B0risma/CapMeter/схемы.docx

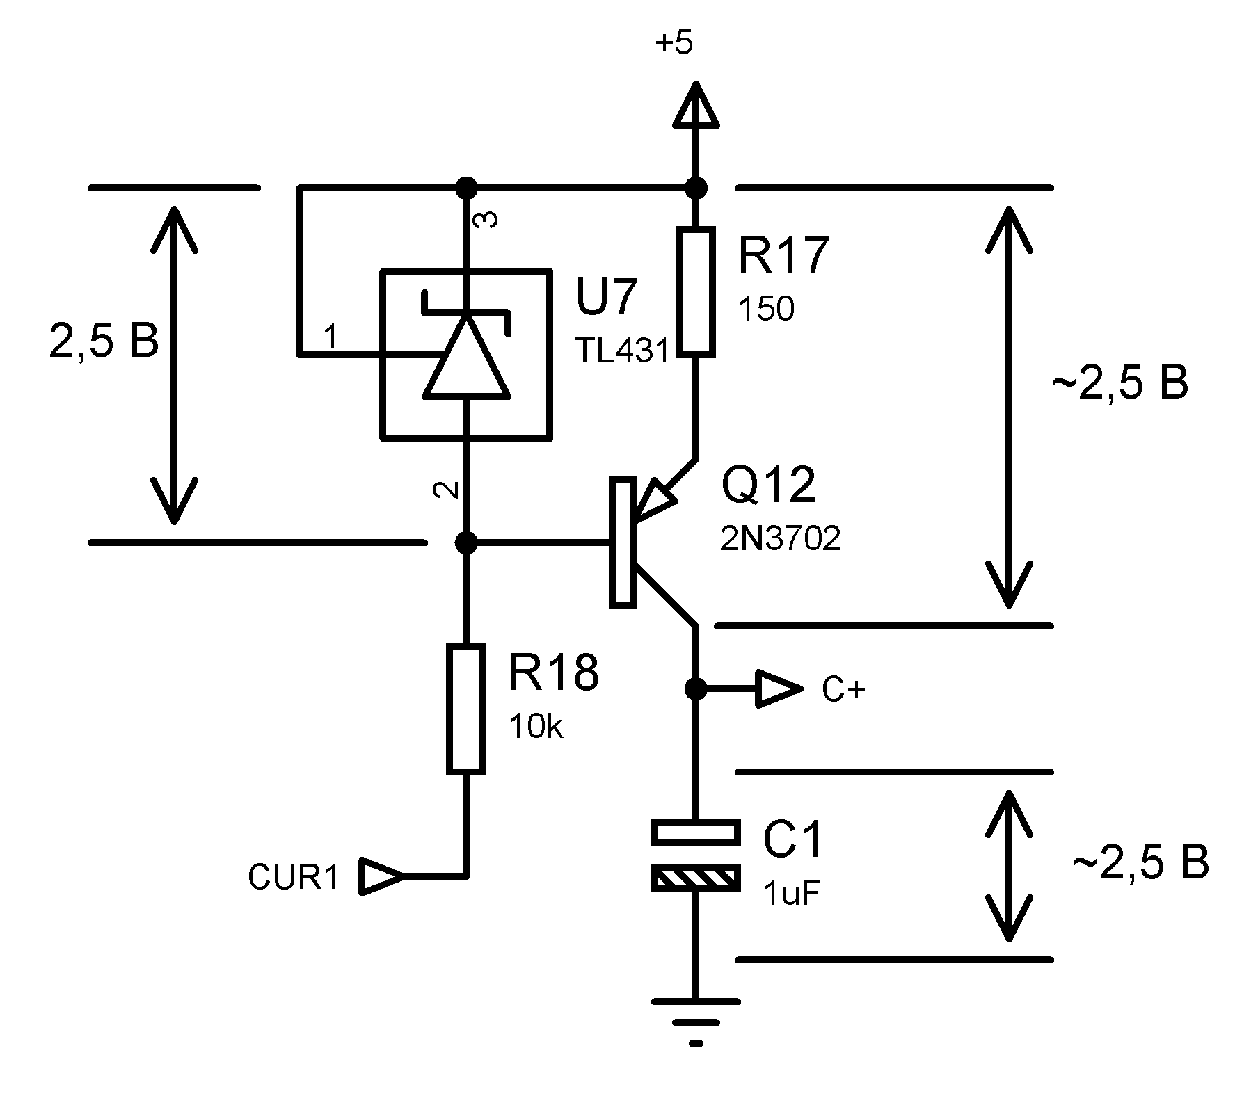
[picture p22: figure]
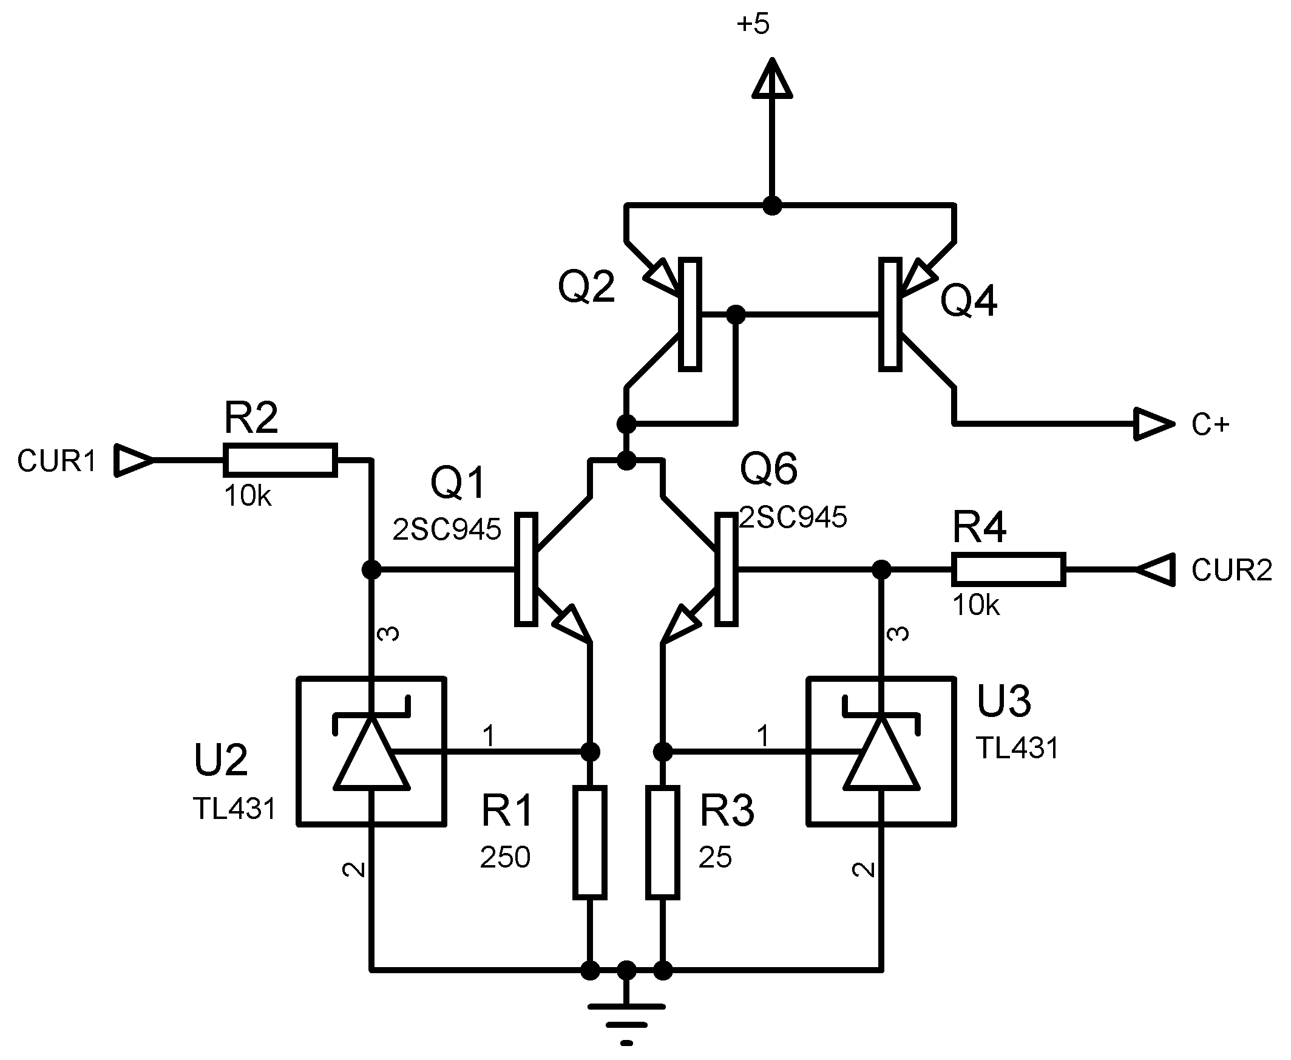
[picture p23: figure]
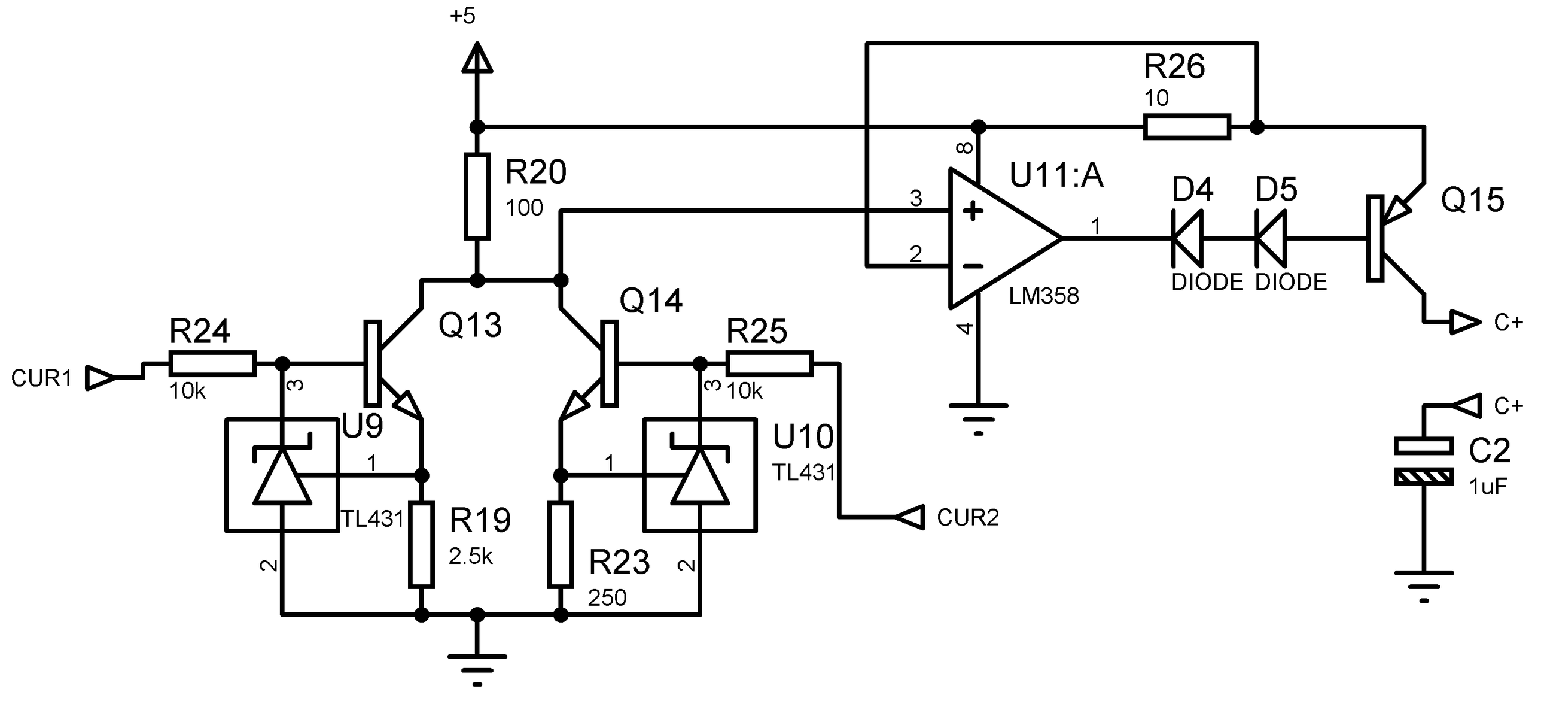
[picture p24: figure]
