B0risma/CapMeter/din41328-4_1974-06d(измерение емкости).pdf

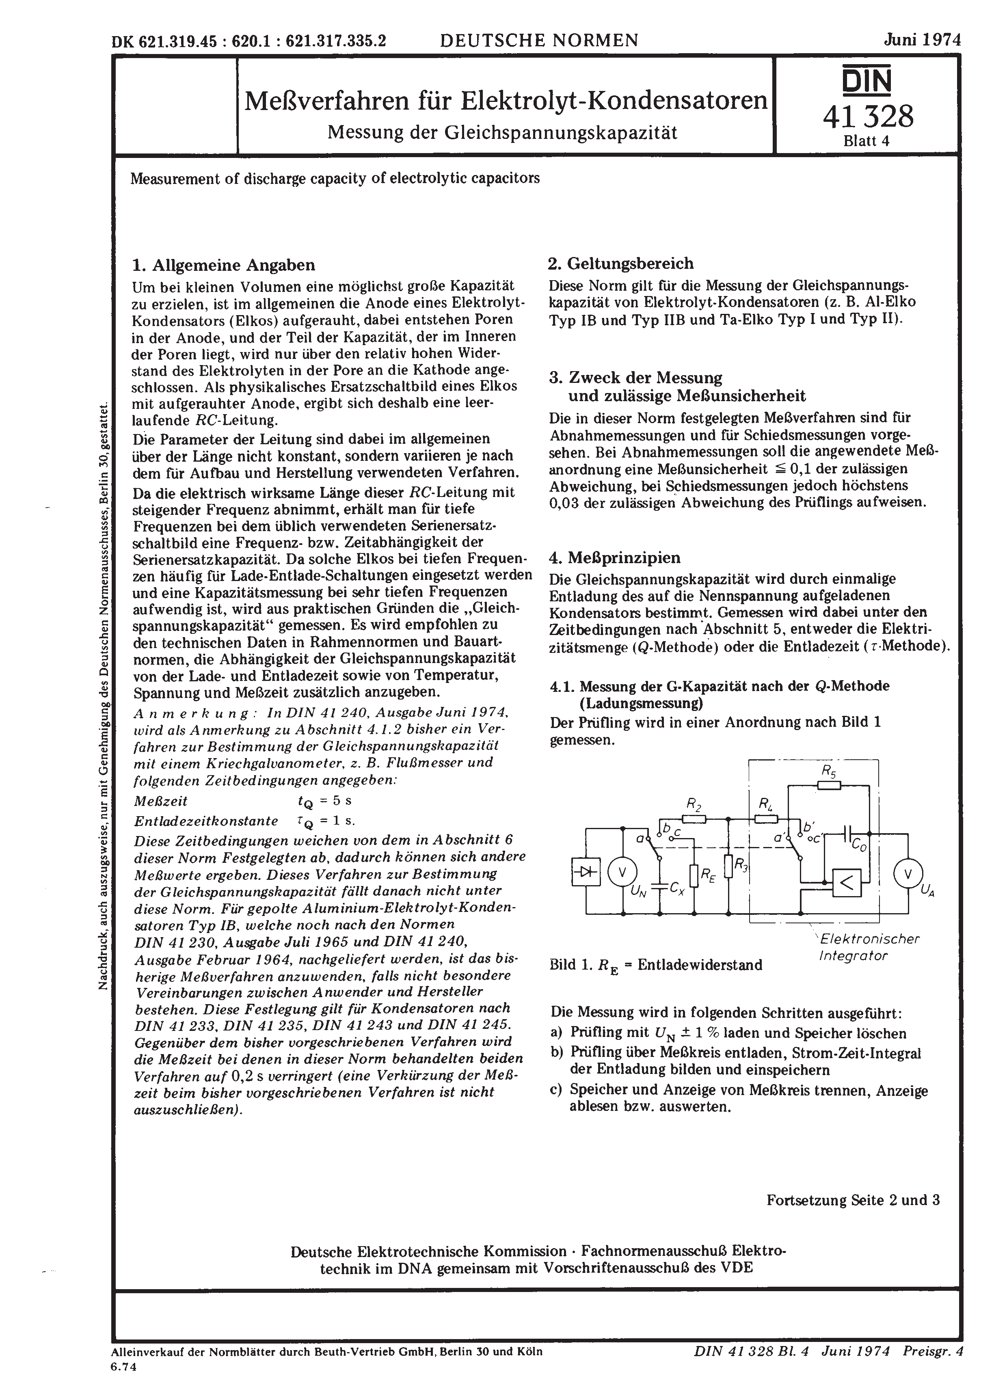
[picture p25: page 1]
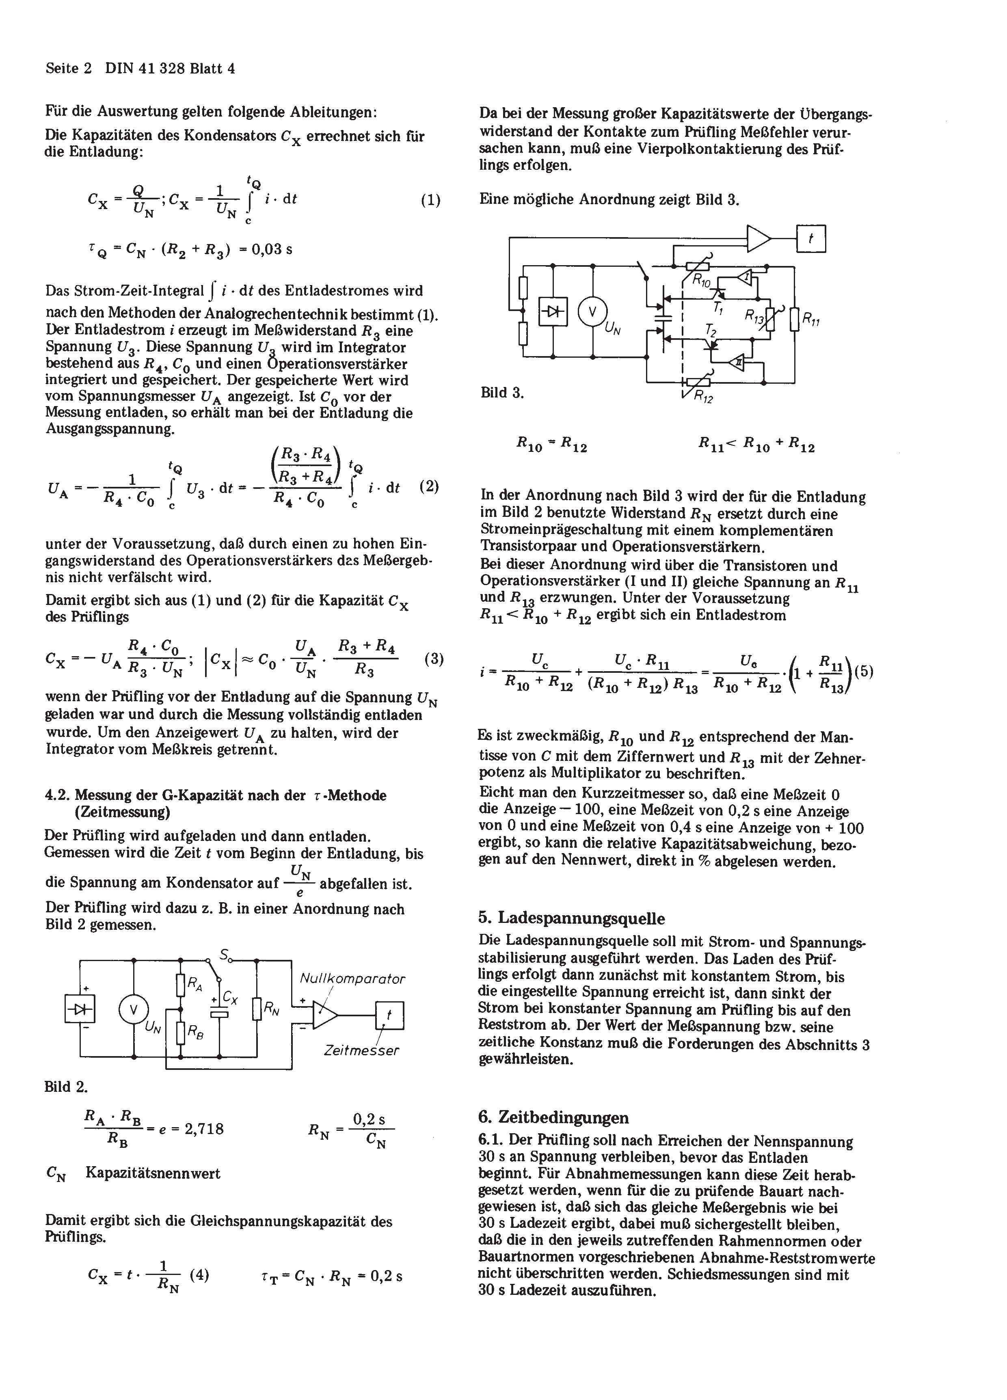
[picture p26: page 2]
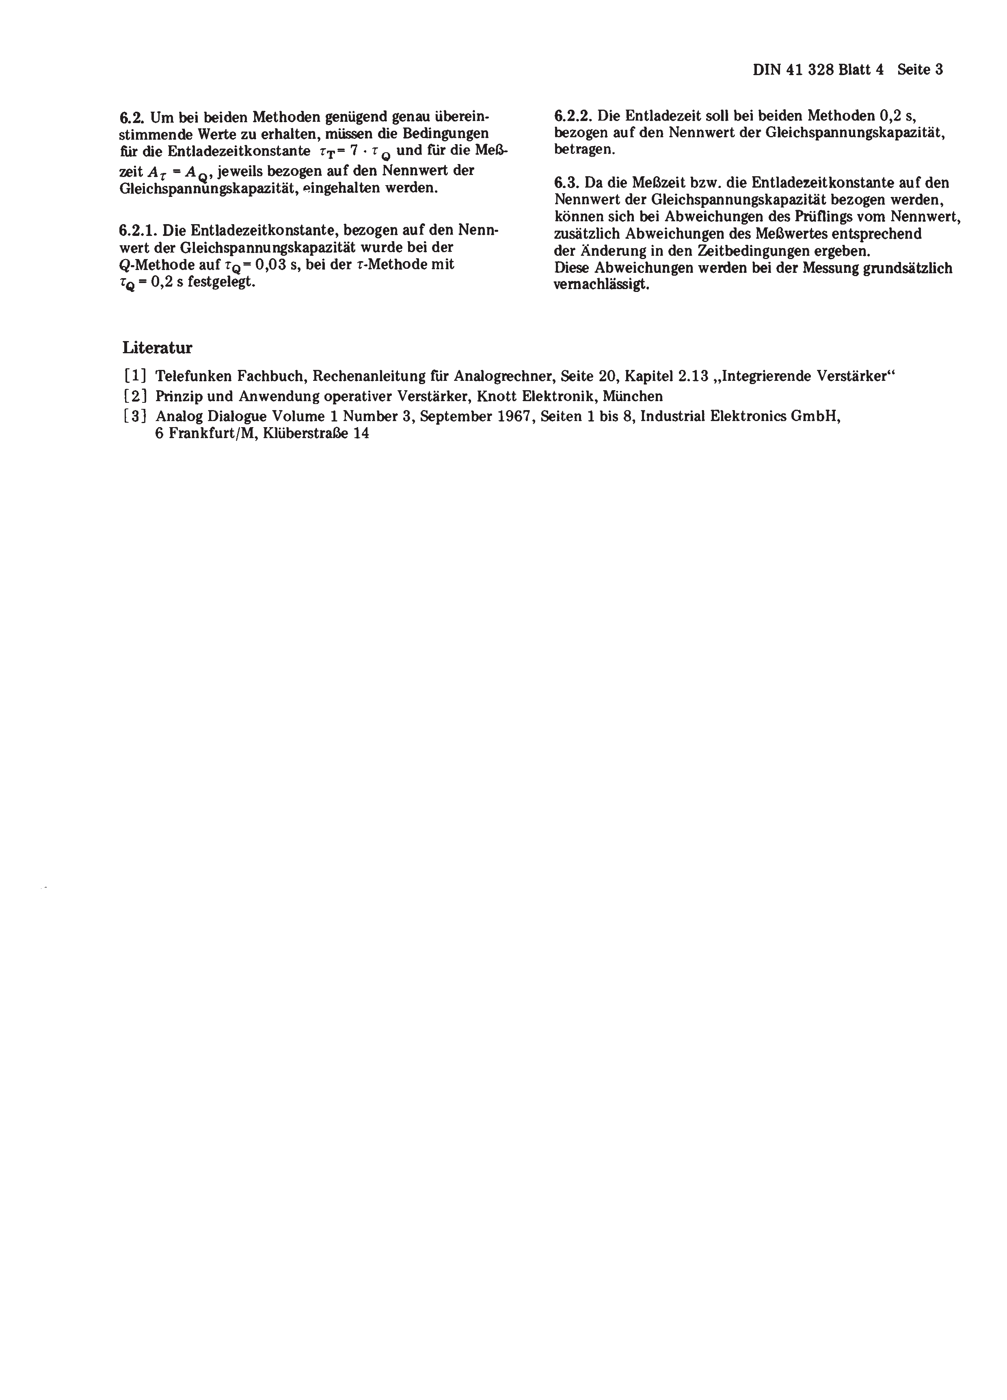
[picture p27: page 3]
