B0risma/CapMeter/cxem.BMP

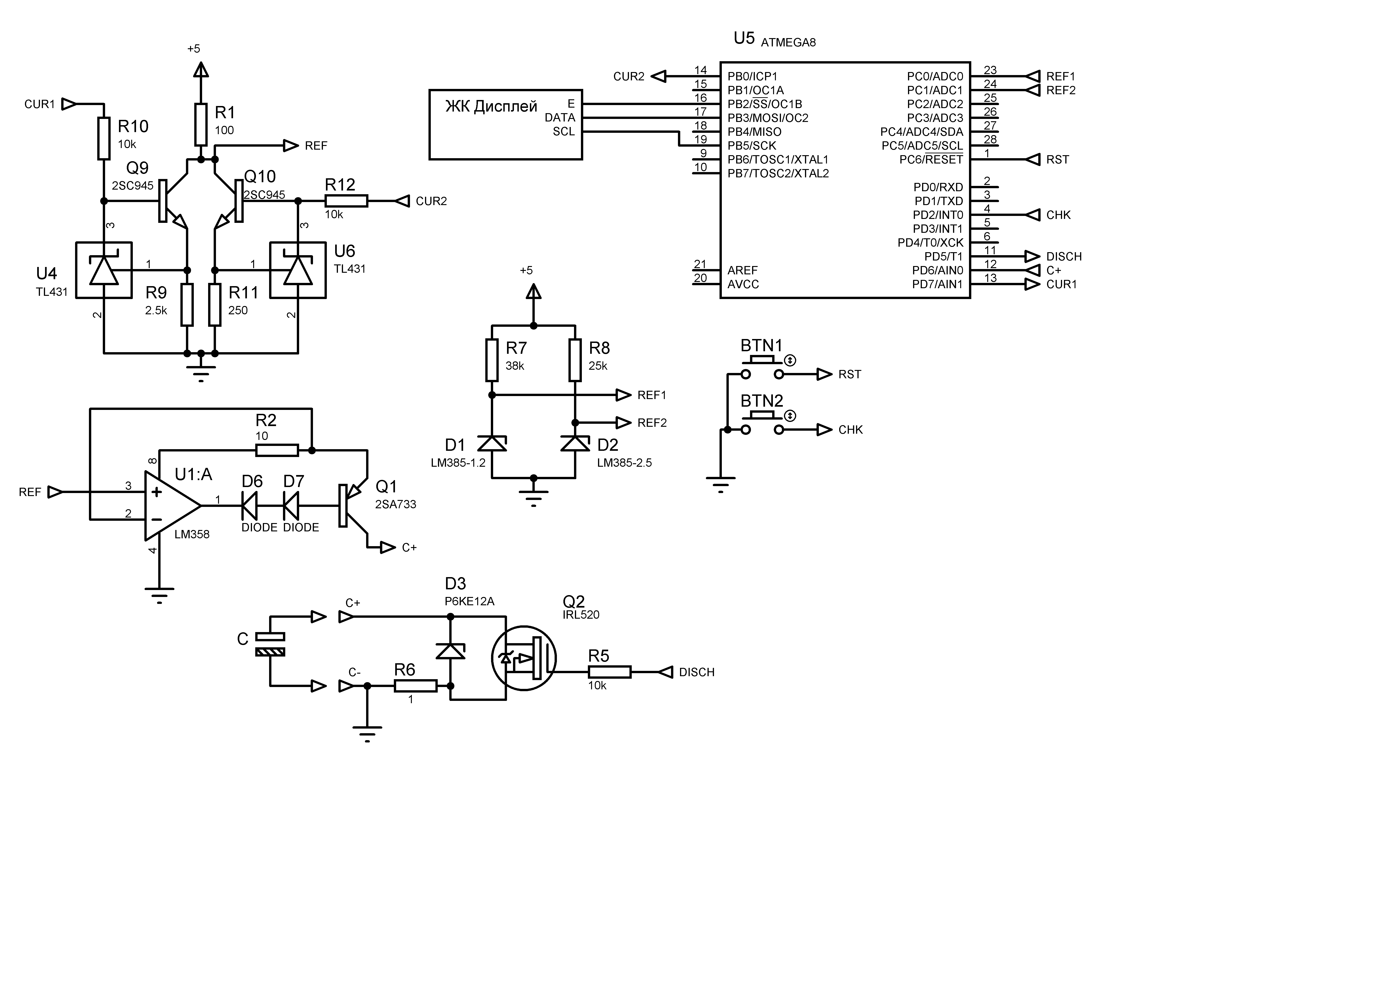
cxem.BMP
