B0risma/CapMeter/ESR4.jpg

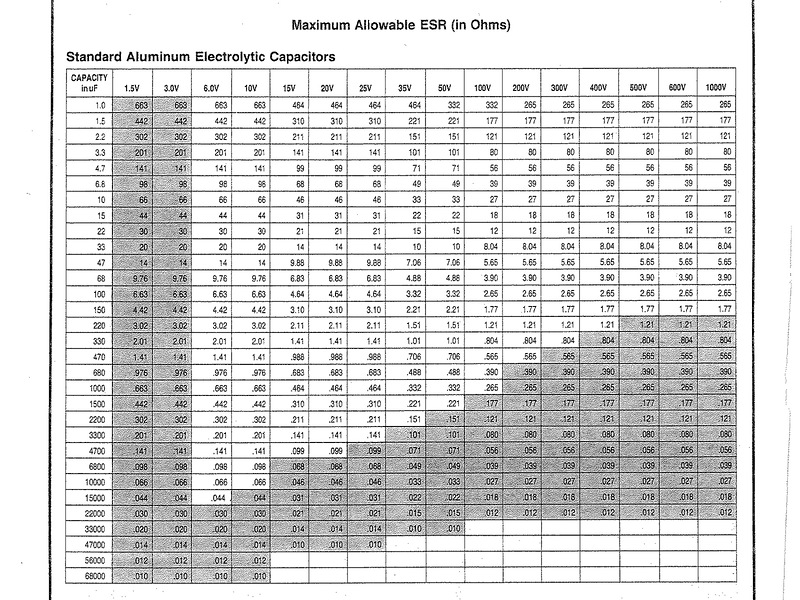
ESR4.jpg
