B0risma/CapMeter/ESR.jpg

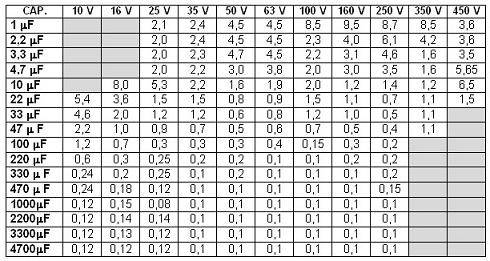
ESR.jpg
