B0risma/CapMeter/LCD_board.bmp

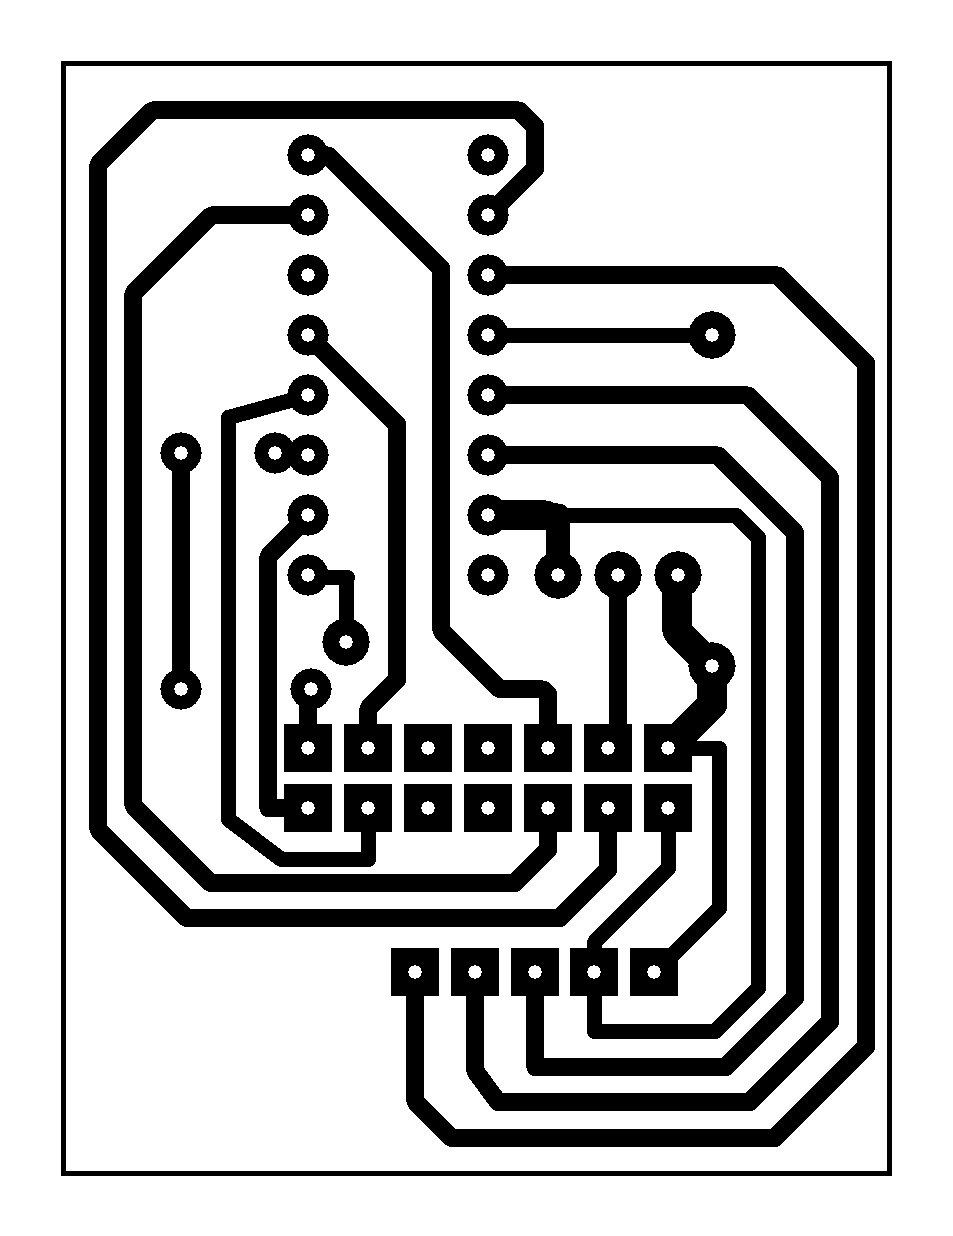
LCD_board.bmp
