B0risma/CapMeter/Screenshot_1.png

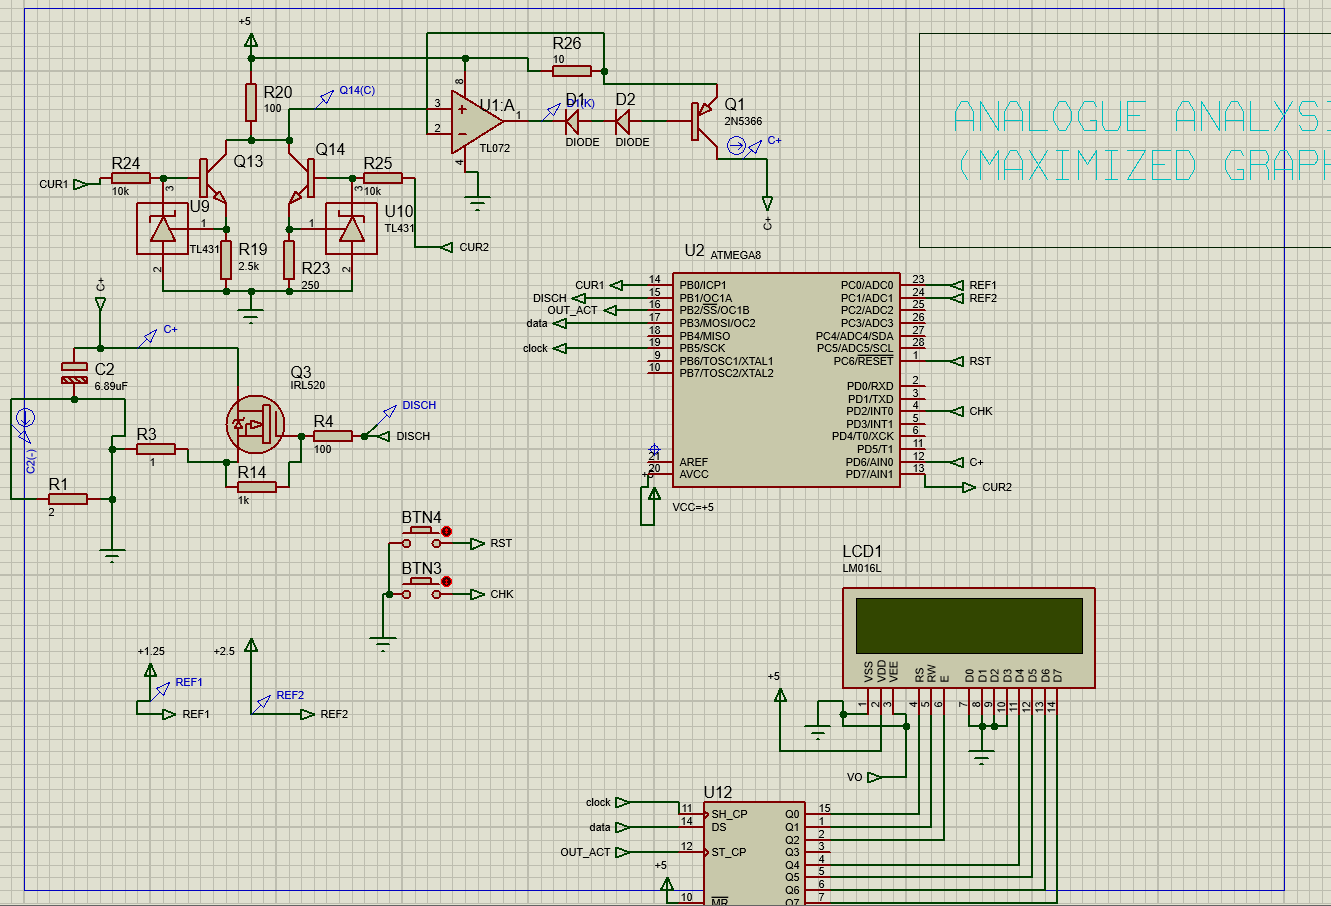
Screenshot_1.png
