B0risma/CapMeter/алгоритм.jpg

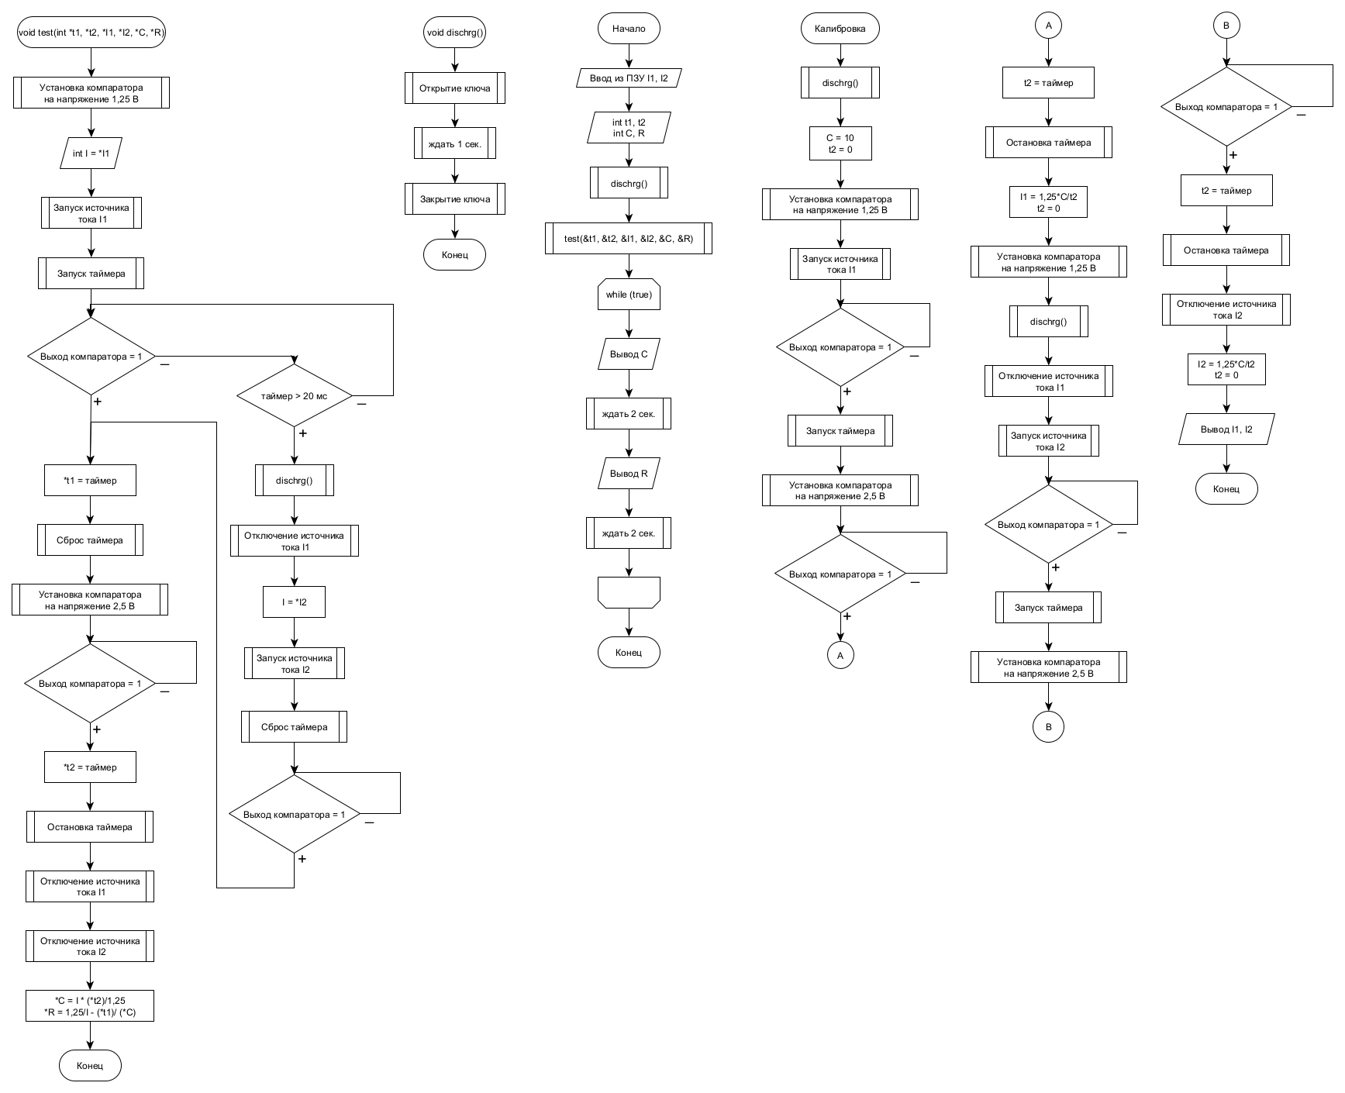
алгоритм.jpg
