B0risma/CapMeter/Осциллограмма измерения ESR.png

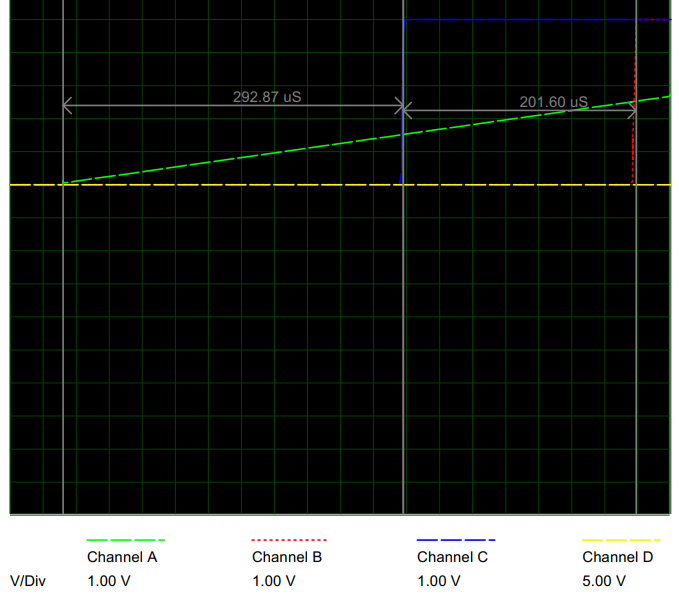
Осциллограмма измерения ESR.png
