B0risma/CapMeter/ток2.bmp

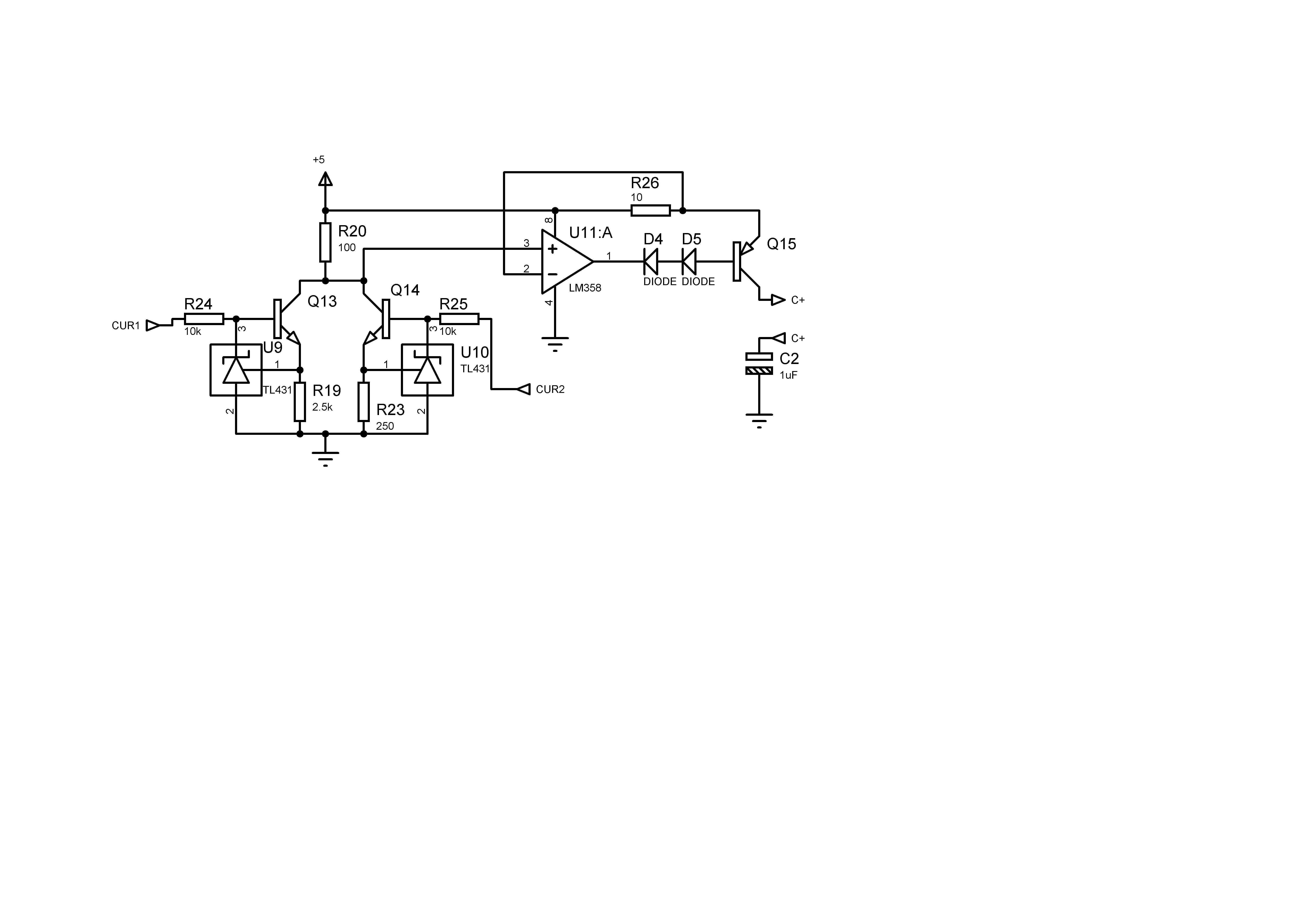
ток2.bmp
