B0risma/CapMeter/ток.bmp

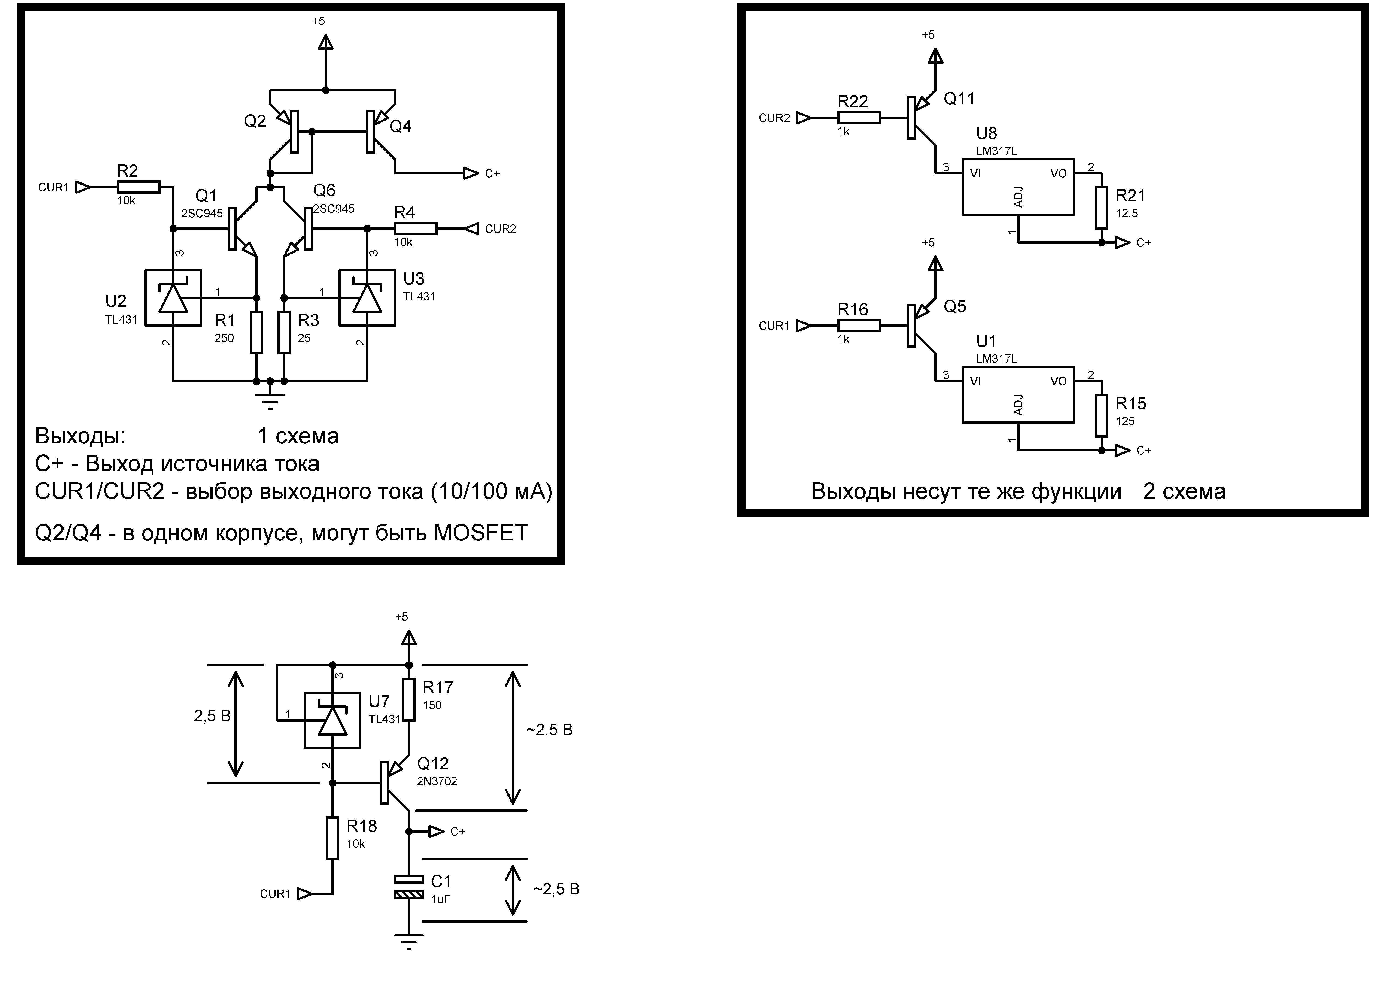
ток.bmp
