B0risma/CapMeter/(list of files, drawings)

Other design files:
branch2/168.pdsprj
cxem.pdsprj
pcb .pdsprj
