B0risma/CapMeter/(commit log)

2021-09-24 Beta
    noise canceler/ allright
    [Cmeter.c]
2021-10-01 Update Cmeter.c
    disable pull-up for adc measuring
